Gilberto117mx/Custodia-ISL-PCB-firmware-RAK4630-v1/tests/ISL_Flash_Probe/probe_result.txt

ISL flash probe: walking api.system.flash ...
  ok up to 0x0000 (0 B)
  ok up to 0x1000 (4096 B)
  ok up to 0x2000 (8192 B)
  ok up to 0x3000 (12288 B)
  ok up to 0x4000 (16384 B)
  ok up to 0x5000 (20480 B)
  ok up to 0x6000 (24576 B)
  ok up to 0x7000 (28672 B)
  ok up to 0x8000 (32768 B)
  ok up to 0x9000 (36864 B)
  ok up to 0xA000 (40960 B)
  ok up to 0xB000 (45056 B)
  ok up to 0xC000 (49152 B)
  ok up to 0xD000 (53248 B)
  ok up to 0xE000 (57344 B)
  ok up to 0xF000 (61440 B)
  ok up to 0x10000 (65536 B)
  ok up to 0x11000 (69632 B)
  ok up to 0x12000 (73728 B)
  ok up to 0x13000 (77824 B)
  ok up to 0x14000 (81920 B)
  ok up to 0x15000 (86016 B)
  ok up to 0x16000 (90112 B)
  ok up to 0x17000 (94208 B)
  ok up to 0x18000 (98304 B)
  ok up to 0x19000 (102400 B)
  ok up to 0x1A000 (106496 B)
  ok up to 0x1B000 (110592 B)
  ok up to 0x1C000 (114688 B)
  ok up to 0x1D000 (118784 B)
  ok up to 0x1E000 (122880 B)
  ok up to 0x1F000 (126976 B)
  ok up to 0x20000 (131072 B)
  ceiling at offset 0x21000 (135168 B): set=0 get=0 match=0

=== USABLE api.system.flash ~= 134928 bytes (131 KB) ===
accel records that fit (record = 12 + samples*6 bytes):
  10s @ 10 Hz = 100 samp ->  612 B/rec ->  220 records fit  (~55.0 days @ 6 h cadence)
  10s @  5 Hz =  50 samp ->  312 B/rec ->  432 records fit  (~108.0 days @ 6 h cadence)
   5s @ 10 Hz =  50 samp ->  312 B/rec ->  432 records fit  (~108.0 days @ 6 h cadence)
   5s @  5 Hz =  25 samp ->  162 B/rec ->  832 records fit  (~208.0 days @ 6 h cadence)
   5s @  4 Hz =  20 samp ->  132 B/rec -> 1021 records fit  (~255.2 days @ 6 h cadence)
   3s @  5 Hz =  15 samp ->  102 B/rec -> 1322 records fit  (~330.5 days @ 6 h cadence)

Done. Re-flash production firmware to start with clean flash.
