Gilberto117mx/Custodia-ISL-PCB-firmware-RAK4630-v1/tests/ISL_DeepSleep_Baseline/PowerProfile_baseline.csv

Timestamp(ms) | Current(uA)
0 | 0.149
10 | 0.156
20 | 0.168
30 | 0.171
40 | 0.167
50 | 0.154
60 | 0.151
70 | 0.157
80 | 0.164
90 | 0.157
100 | 0.156
110 | 0.160
120 | 0.164
130 | 0.161
140 | 0.164
150 | 0.172
160 | 0.176
170 | 0.168
180 | 0.166
190 | 0.167
200 | 0.175
210 | 0.179
220 | 0.177
230 | 0.167
240 | 0.156
250 | 0.156
260 | 0.156
270 | 0.153
280 | 0.154
290 | 0.155
300 | 0.151
310 | 0.158
320 | 0.154
330 | 0.157
340 | 0.156
350 | 0.150
360 | 0.145
370 | 0.143
380 | 0.132
390 | 0.141
400 | 0.149
410 | 0.151
420 | 0.144
430 | 0.136
440 | 0.143
450 | 0.140
460 | 0.136
470 | 0.140
480 | 0.134
490 | 0.136
500 | 0.134
510 | 0.138
520 | 0.137
530 | 0.136
540 | 0.140
550 | 0.146
560 | 0.146
570 | 0.147
580 | 0.141
590 | 0.133
600 | 0.136
610 | 0.131
620 | 0.127
630 | 0.133
640 | 0.135
650 | 0.139
660 | 0.136
670 | 0.140
680 | 0.134
690 | 0.132
700 | 0.132
710 | 0.138
720 | 0.137
730 | 0.135
740 | 0.134
750 | 0.134
760 | 0.128
770 | 0.116
780 | 0.119
790 | 0.123
800 | 0.131
810 | 0.132
820 | 0.135
830 | 0.128
840 | 0.116
850 | 0.116
860 | 0.129
870 | 0.136
880 | 0.135
890 | 0.130
900 | 0.134
910 | 0.122
920 | 0.117
930 | 0.116
940 | 0.118
950 | 0.125
960 | 0.133
970 | 0.123
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
