Gilberto117mx/Custodia-ISL-PCB-firmware-RAK4630-v1/tests/ISL_GNSS_DutyCycle/PowerProfile_v2_phantom-power.csv

Timestamp(ms) | Current(uA)
0 | 0.196
10 | 0.193
20 | 0.188
30 | 0.186
40 | 0.186
50 | 0.183
60 | 0.186
70 | 0.186
80 | 0.190
90 | 0.195
100 | 0.196
110 | 0.190
120 | 0.180
130 | 0.177
140 | 0.188
150 | 0.195
160 | 0.196
170 | 0.191
180 | 0.184
190 | 0.182
200 | 0.187
210 | 0.190
220 | 0.188
230 | 0.189
240 | 0.191
250 | 0.177
260 | 0.172
270 | 0.163
280 | 0.165
290 | 0.157
300 | 0.166
310 | 0.160
320 | 0.167
330 | 0.171
340 | 0.172
350 | 0.176
360 | 0.175
370 | 0.167
380 | 0.161
390 | 0.164
400 | 0.164
410 | 0.168
420 | 0.168
430 | 0.167
440 | 0.163
450 | 0.160
460 | 0.158
470 | 0.150
480 | 0.155
490 | 0.158
500 | 0.145
510 | 0.155
520 | 0.155
530 | 0.156
540 | 0.154
550 | 0.157
560 | 0.156
570 | 0.164
580 | 0.172
590 | 0.177
600 | 0.171
610 | 0.172
620 | 0.170
630 | 0.170
640 | 0.160
650 | 0.158
660 | 0.157
670 | 0.159
680 | 0.153
690 | 0.158
700 | 0.156
710 | 0.151
720 | 0.163
730 | 0.155
740 | 0.146
750 | 0.141
760 | 0.146
770 | 0.148
780 | 0.149
790 | 0.153
800 | 0.149
810 | 0.146
820 | 0.144
830 | 0.143
840 | 0.163
850 | 0.156
860 | 0.151
870 | 0.157
880 | 0.153
890 | 0.148
900 | 0.152
910 | 0.147
920 | 0.144
930 | 0.151
940 | 0.153
950 | 0.143
960 | 0.140
970 | 0.142
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
