Gilberto117mx/Custodia-ISL-PCB-firmware-RAK4630-v1/tests/ISL_GNSS_DutyCycle/PowerProfile_v3_isolated.csv

Timestamp(ms) | Current(uA)
0 | 0.138
10 | 0.166
20 | 0.169
30 | 0.170
40 | 0.171
50 | 0.171
60 | 0.171
70 | 0.168
80 | 0.168
90 | 0.174
100 | 0.173
110 | 0.166
120 | 0.162
130 | 0.162
140 | 0.156
150 | 0.167
160 | 0.166
170 | 0.171
180 | 0.167
190 | 0.161
200 | 0.160
210 | 0.167
220 | 0.156
230 | 0.153
240 | 0.154
250 | 0.159
260 | 0.158
270 | 0.151
280 | 0.159
290 | 0.162
300 | 0.158
310 | 0.170
320 | 0.172
330 | 0.160
340 | 0.161
350 | 0.152
360 | 0.147
370 | 0.147
380 | 0.151
390 | 0.154
400 | 0.151
410 | 0.141
420 | 0.151
430 | 0.143
440 | 0.142
450 | 0.153
460 | 0.156
470 | 0.164
480 | 0.168
490 | 0.163
500 | 0.165
510 | 0.165
520 | 0.162
530 | 0.157
540 | 0.155
550 | 0.154
560 | 0.160
570 | 0.151
580 | 0.148
590 | 0.139
600 | 0.135
610 | 0.135
620 | 0.143
630 | 0.138
640 | 0.139
650 | 0.134
660 | 0.129
670 | 0.137
680 | 0.127
690 | 0.130
700 | 0.131
710 | 0.126
720 | 0.125
730 | 0.128
740 | 0.125
750 | 0.117
760 | 0.117
770 | 0.123
780 | 0.129
790 | 0.125
800 | 0.122
810 | 0.130
820 | 0.118
830 | 0.118
840 | 0.118
850 | 0.113
860 | 0.109
870 | 0.120
880 | 0.125
890 | 0.123
900 | 0.128
910 | 0.120
920 | 0.118
930 | 0.121
940 | 0.126
950 | 0.138
960 | 0.137
970 | 0.136
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
