Gilberto117mx/Custodia-ISL-PCB-firmware-RAK4630-v1/production/v6/tests/test2_delivery_guarantee/Tracker_test2.txt

ISL Production v6 boot. Heartbeat, then init...
Current Work Mode: LoRa P2P.
[alive] 0 ms
[alive] 500 ms
[alive] 1000 ms
[alive] 1500 ms
[alive] 2000 ms
[alive] 2500 ms
[alive] 3000 ms
========================================================
ISL Board - PRODUCTION v6  (SV-gated GPS + backoff + fix re-sync + delivery guarantee)
========================================================
[RTC] NOT GPS-synced (will seed from GNSS)  current: 2000-01-01 00:00:05
[FLASH] Loaded: nextSeq=77 delivered=69 undelivered=1 buf=0 pend=5
[TIME] boot GPS time-sync (up to 120 s, no fix needed)...
[GPS] VCC ON (P1.02 LOW, hot start via module backup battery)
   ...0s  sats=0  timeValid=0 year=0
[RTC] SET FROM GPS: 2026-07-15 08:16:10 UTC (unix~1784103370)
[GPS] VCC OFF, UART pins driven LOW (module isolated)
[CFG] id=051  period=2 min (1Hz tick)  SV_MIN=4  no_sky_abort=25 s  fix_max=120 s  settle=5 s  ack=8 s  backoff=K999/360min  tx_gap=30 s  buffer=1  pend_slots=5  WUR_wake=0  SIM_FIX=1  rtcSynced=1
== COLLECT (cycle 1, up 8 s, noFixStreak=0) ==
[BAT] 3905 mV
[GPS] SIMULATED FIX  used=12  IN-VIEW=12  lat=22528600 lon=113940480  ts=1784103370
[BUF] staged seq=77 (fix), buf=1/1  pend=5
[TX pass] cycle=1 buffer=1 pending=5
[TX] seq=77 (fix): 051,77,22.528600,113.940480,3.90,1784103370,SV=12
+EVT:TXP2P DONE
+EVT:RXP2P RECEIVE TIMEOUT
[RX] not-ACK ("")
[TX pass] done: delivered=69 lastSeq=70 pending=5 undelivered=2
== IDLE deep-sleep 120 s ==
[SLEEP] 120 s
[RTC] timer: preset=120 s (1 Hz tick)
[WAKE] RTC P0.21 after ~120002 ms
== COLLECT (cycle 2, up 137 s, noFixStreak=0) ==
[BAT] 3920 mV
[GPS] SIMULATED FIX  used=12  IN-VIEW=12  lat=22528600 lon=113940480  ts=1784103499
[BUF] staged seq=78 (fix), buf=1/1  pend=5
[TX pass] cycle=2 buffer=1 pending=5
[TX] seq=78 (fix): 051,78,22.528600,113.940480,3.92,1784103499,SV=12
+EVT:TXP2P DONE
+EVT:RXP2P RECEIVE TIMEOUT
[RX] not-ACK ("")
[TX pass] done: delivered=69 lastSeq=70 pending=5 undelivered=3
== IDLE deep-sleep 120 s ==
[SLEEP] 120 s
[RTC] timer: preset=120 s (1 Hz tick)
[WAKE] RTC P0.21 after ~120002 ms
== COLLECT (cycle 3, up 266 s, noFixStreak=0) ==
[BAT] 3920 mV
[GPS] SIMULATED FIX  used=12  IN-VIEW=12  lat=22528600 lon=113940480  ts=1784103628
[BUF] staged seq=79 (fix), buf=1/1  pend=5
[TX pass] cycle=3 buffer=1 pending=5
[TX] seq=79 (fix): 051,79,22.528600,113.940480,3.92,1784103628,SV=12
+EVT:TXP2P DONE
+EVT:RXP2P RECEIVE TIMEOUT
[RX] not-ACK ("")
[TX pass] done: delivered=69 lastSeq=70 pending=5 undelivered=4
== IDLE deep-sleep 120 s ==
[SLEEP] 120 s
[RTC] timer: preset=120 s (1 Hz tick)
[WAKE] RTC P0.21 after ~120002 ms
== COLLECT (cycle 4, up 395 s, noFixStreak=0) ==
[BAT] 3920 mV
[GPS] SIMULATED FIX  used=12  IN-VIEW=12  lat=22528600 lon=113940480  ts=1784103757
[BUF] staged seq=80 (fix), buf=1/1  pend=5
[TX pass] cycle=4 buffer=1 pending=5
[TX] seq=80 (fix): 051,80,22.528600,113.940480,3.92,1784103757,SV=12
+EVT:TXP2P DONE
+EVT:RXP2P RECEIVE TIMEOUT
[RX] not-ACK ("")
[TX pass] done: delivered=69 lastSeq=70 pending=5 undelivered=5
== IDLE deep-sleep 120 s ==
[SLEEP] 120 s
[RTC] timer: preset=120 s (1 Hz tick)
[WAKE] RTC P0.21 after ~120002 ms
== COLLECT (cycle 5, up 524 s, noFixStreak=0) ==
[BAT] 3920 mV
[GPS] SIMULATED FIX  used=12  IN-VIEW=12  lat=22528600 lon=113940480  ts=1784103886
[BUF] staged seq=81 (fix), buf=1/1  pend=5
[TX pass] cycle=5 buffer=1 pending=5
[TX] seq=81 (fix): 051,81,22.528600,113.940480,3.92,1784103886,SV=12
+EVT:TXP2P DONE
+EVT:RXP2P RECEIVE TIMEOUT
[RX] not-ACK ("")
[TX pass] done: delivered=69 lastSeq=70 pending=5 undelivered=6
== IDLE deep-sleep 120 s ==
[SLEEP] 120 s
[RTC] timer: preset=120 s (1 Hz tick)
[WAKE] RTC P0.21 after ~120002 ms
== COLLECT (cycle 6, up 653 s, noFixStreak=0) ==
[BAT] 3918 mV
[GPS] SIMULATED FIX  used=12  IN-VIEW=12  lat=22528600 lon=113940480  ts=1784104015
[BUF] staged seq=82 (fix), buf=1/1  pend=5
[TX pass] cycle=6 buffer=1 pending=5
[TX] seq=82 (fix): 051,82,22.528600,113.940480,3.91,1784104015,SV=12
+EVT:TXP2P DONE
+EVT:RXP2P RECEIVE TIMEOUT
[RX] not-ACK ("")
[TX pass] done: delivered=69 lastSeq=70 pending=5 undelivered=7
== IDLE deep-sleep 120 s ==
[SLEEP] 120 s
[RTC] timer: preset=120 s (1 Hz tick)
[WAKE] RTC P0.21 after ~120002 ms
== COLLECT (cycle 7, up 782 s, noFixStreak=0) ==
[BAT] 3922 mV
[GPS] SIMULATED FIX  used=12  IN-VIEW=12  lat=22528600 lon=113940480  ts=1784104144
[BUF] staged seq=83 (fix), buf=1/1  pend=5
[TX pass] cycle=7 buffer=1 pending=5
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
[GPS] SIMULATED FIX  used=12  IN-VIEW=12  lat=22528600 lon=113940480  ts=1784105032
[BUF] staged seq=89 (fix), buf=1/1  pend=0
[TX pass] cycle=13 buffer=1 pending=0
[TX] seq=89 (fix): 051,89,22.528600,113.940480,3.92,1784105032,SV=12
+EVT:TXP2P DONE
+EVT:RXP2P:-43:12:41434B2C3035312C3839
[RX] ACK OK  RSSI=-43 dBm  SNR=12 dB
[TX pass] done: delivered=79 lastSeq=89 pending=0 undelivered=9
== IDLE deep-sleep 120 s ==
[SLEEP] 120 s
[RTC] timer: preset=120 s (1 Hz tick)
[WAKE] RTC P0.21 after ~120002 ms
== COLLECT (cycle 14, up 1791 s, noFixStreak=0) ==
[BAT] 3922 mV
[GPS] SIMULATED FIX  used=12  IN-VIEW=12  lat=22528600 lon=113940480  ts=1784105153
[BUF] staged seq=90 (fix), buf=1/1  pend=0
[TX pass] cycle=14 buffer=1 pending=0
[TX] seq=90 (fix): 051,90,22.528600,113.940480,3.92,1784105153,SV=12
+EVT:TXP2P DONE
