Gilberto117mx/Custodia-ISL-PCB-firmware-RAK4630-v1/production/v9/tests/run1_offload_freeze/PowerProfile_USB.csv

Timestamp(ms) | Current(uA)
0 | 43973.828
10 | 44186.281
20 | 43983.094
30 | 43707.031
40 | 43708.441
50 | 44051.719
60 | 44161.512
70 | 43609.816
80 | 43437.457
90 | 43694.848
100 | 43667.754
110 | 43526.535
120 | 43530.848
130 | 43853.684
140 | 43857.953
150 | 43869.301
160 | 43954.832
170 | 44235.293
180 | 44077.715
190 | 43983.281
200 | 43718.848
210 | 43674.629
220 | 43831.023
230 | 43610.117
240 | 43811.750
250 | 43577.898
260 | 43827.250
270 | 43979.270
280 | 43810.207
290 | 43941.363
300 | 43416.352
310 | 43687.121
320 | 43696.695
330 | 43927.598
340 | 44216.496
350 | 44168.738
360 | 44348.844
370 | 44154.051
380 | 44418.051
390 | 44116.723
400 | 44284.387
410 | 44373.641
420 | 44055.703
430 | 44255.930
440 | 44131.910
450 | 44346.637
460 | 43842.785
470 | 43601.746
480 | 43200.898
490 | 43073.918
500 | 43256.453
510 | 43314.125
520 | 43406.965
530 | 43572.652
540 | 43636.496
550 | 43678.758
560 | 43541.586
570 | 43460.000
580 | 43463.301
590 | 43805.402
600 | 43221.473
610 | 43022.820
620 | 43066.617
630 | 43115.617
640 | 42870.645
650 | 42746.645
660 | 43456.723
670 | 43495.516
680 | 43506.172
690 | 43510.637
700 | 43618.375
710 | 43789.953
720 | 43552.316
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
