Gilberto117mx/Custodia-ISL-PCB-firmware-RAK4630-v1/production/v6/tests/test2_delivery_guarantee/PowerProfile_test2.csv

Timestamp(ms) | Current(uA)
0 | 1776.286
10 | 653.905
20 | 240.790
30 | 88.734
40 | 32.764
50 | 12.159
60 | 4.577
70 | 1.788
80 | 0.757
90 | 0.381
100 | 0.239
110 | 0.188
120 | 0.173
130 | 0.174
140 | 0.176
150 | 0.176
160 | 0.171
170 | 0.173
180 | 0.177
190 | 0.169
200 | 0.178
210 | 0.171
220 | 0.178
230 | 0.170
240 | 0.173
250 | 0.177
260 | 0.181
270 | 0.176
280 | 0.178
290 | 0.179
300 | 0.177
310 | 0.174
320 | 0.179
330 | 0.183
340 | 0.181
350 | 0.172
360 | 0.172
370 | 0.174
380 | 0.174
390 | 0.176
400 | 0.183
410 | 0.180
420 | 0.180
430 | 0.182
440 | 0.183
450 | 0.172
460 | 0.172
470 | 0.178
480 | 0.177
490 | 0.175
500 | 0.175
510 | 0.180
520 | 0.172
530 | 0.167
540 | 0.168
550 | 0.166
560 | 0.165
570 | 0.158
580 | 0.159
590 | 0.156
600 | 0.159
610 | 0.162
620 | 0.166
630 | 0.163
640 | 0.157
650 | 0.156
660 | 0.161
670 | 0.167
680 | 0.160
690 | 0.164
700 | 0.158
710 | 0.156
720 | 0.160
730 | 0.159
740 | 0.166
750 | 0.171
760 | 0.160
770 | 0.161
780 | 0.153
790 | 0.152
800 | 0.160
810 | 0.170
820 | 0.167
830 | 0.171
840 | 0.169
850 | 0.158
860 | 0.168
870 | 0.161
880 | 0.158
890 | 0.157
900 | 0.173
910 | 0.177
920 | 0.179
930 | 0.172
940 | 0.167
950 | 0.162
960 | 0.168
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
