Gilberto117mx/Custodia-ISL-PCB-firmware-RAK4630-v1/production/v6/tests/test3_longwake_2h/PowerProfile_test3.csv

Timestamp(ms) | Current(uA)
0 | 0.174
100 | 0.168
200 | 0.171
300 | 0.174
400 | 0.180
500 | 0.172
600 | 0.169
700 | 0.170
800 | 0.165
900 | 0.152
1000 | 0.143
1100 | 0.141
1200 | 0.141
1300 | 0.128
1400 | 0.124
1500 | 0.124
1600 | 0.124
1700 | 0.120
1800 | 0.116
1900 | 0.110
2000 | 0.114
2100 | 0.117
2200 | 0.119
2300 | 0.115
2400 | 0.116
2500 | 0.127
2600 | 0.132
2700 | 0.132
2800 | 0.135
2900 | 0.132
3000 | 0.145
3100 | 0.153
3200 | 0.145
3300 | 0.141
3400 | 0.137
3500 | 6830.948
3600 | 8256.943
3700 | 8970.549
3800 | 9440.239
3900 | 9933.642
4000 | 7406.701
4100 | 6522.923
4200 | 6337.229
4300 | 6283.477
4400 | 6283.930
4500 | 5625.116
4600 | 5836.237
4700 | 5184.413
4800 | 4801.847
4900 | 4577.307
5000 | 4466.833
5100 | 4398.633
5200 | 4352.767
5300 | 4320.183
5400 | 4295.695
5500 | 4276.614
5600 | 4261.320
5700 | 4249.637
5800 | 4244.167
5900 | 4238.976
6000 | 4238.445
6100 | 4236.343
6200 | 4235.019
6300 | 4234.773
6400 | 4234.715
6500 | 4234.744
6600 | 4234.458
6700 | 4232.889
6800 | 4233.399
6900 | 4231.964
7000 | 4233.785
7100 | 4234.469
7200 | 4235.229
7300 | 4235.546
7400 | 4237.019
7500 | 4238.398
7600 | 4238.745
7700 | 4234.144
7800 | 4234.289
7900 | 4234.105
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
