Gilberto117mx/Custodia-ISL-PCB-firmware-RAK4630-v1/hardware/iteration3/RAK_feather_schematic_v3.pdf

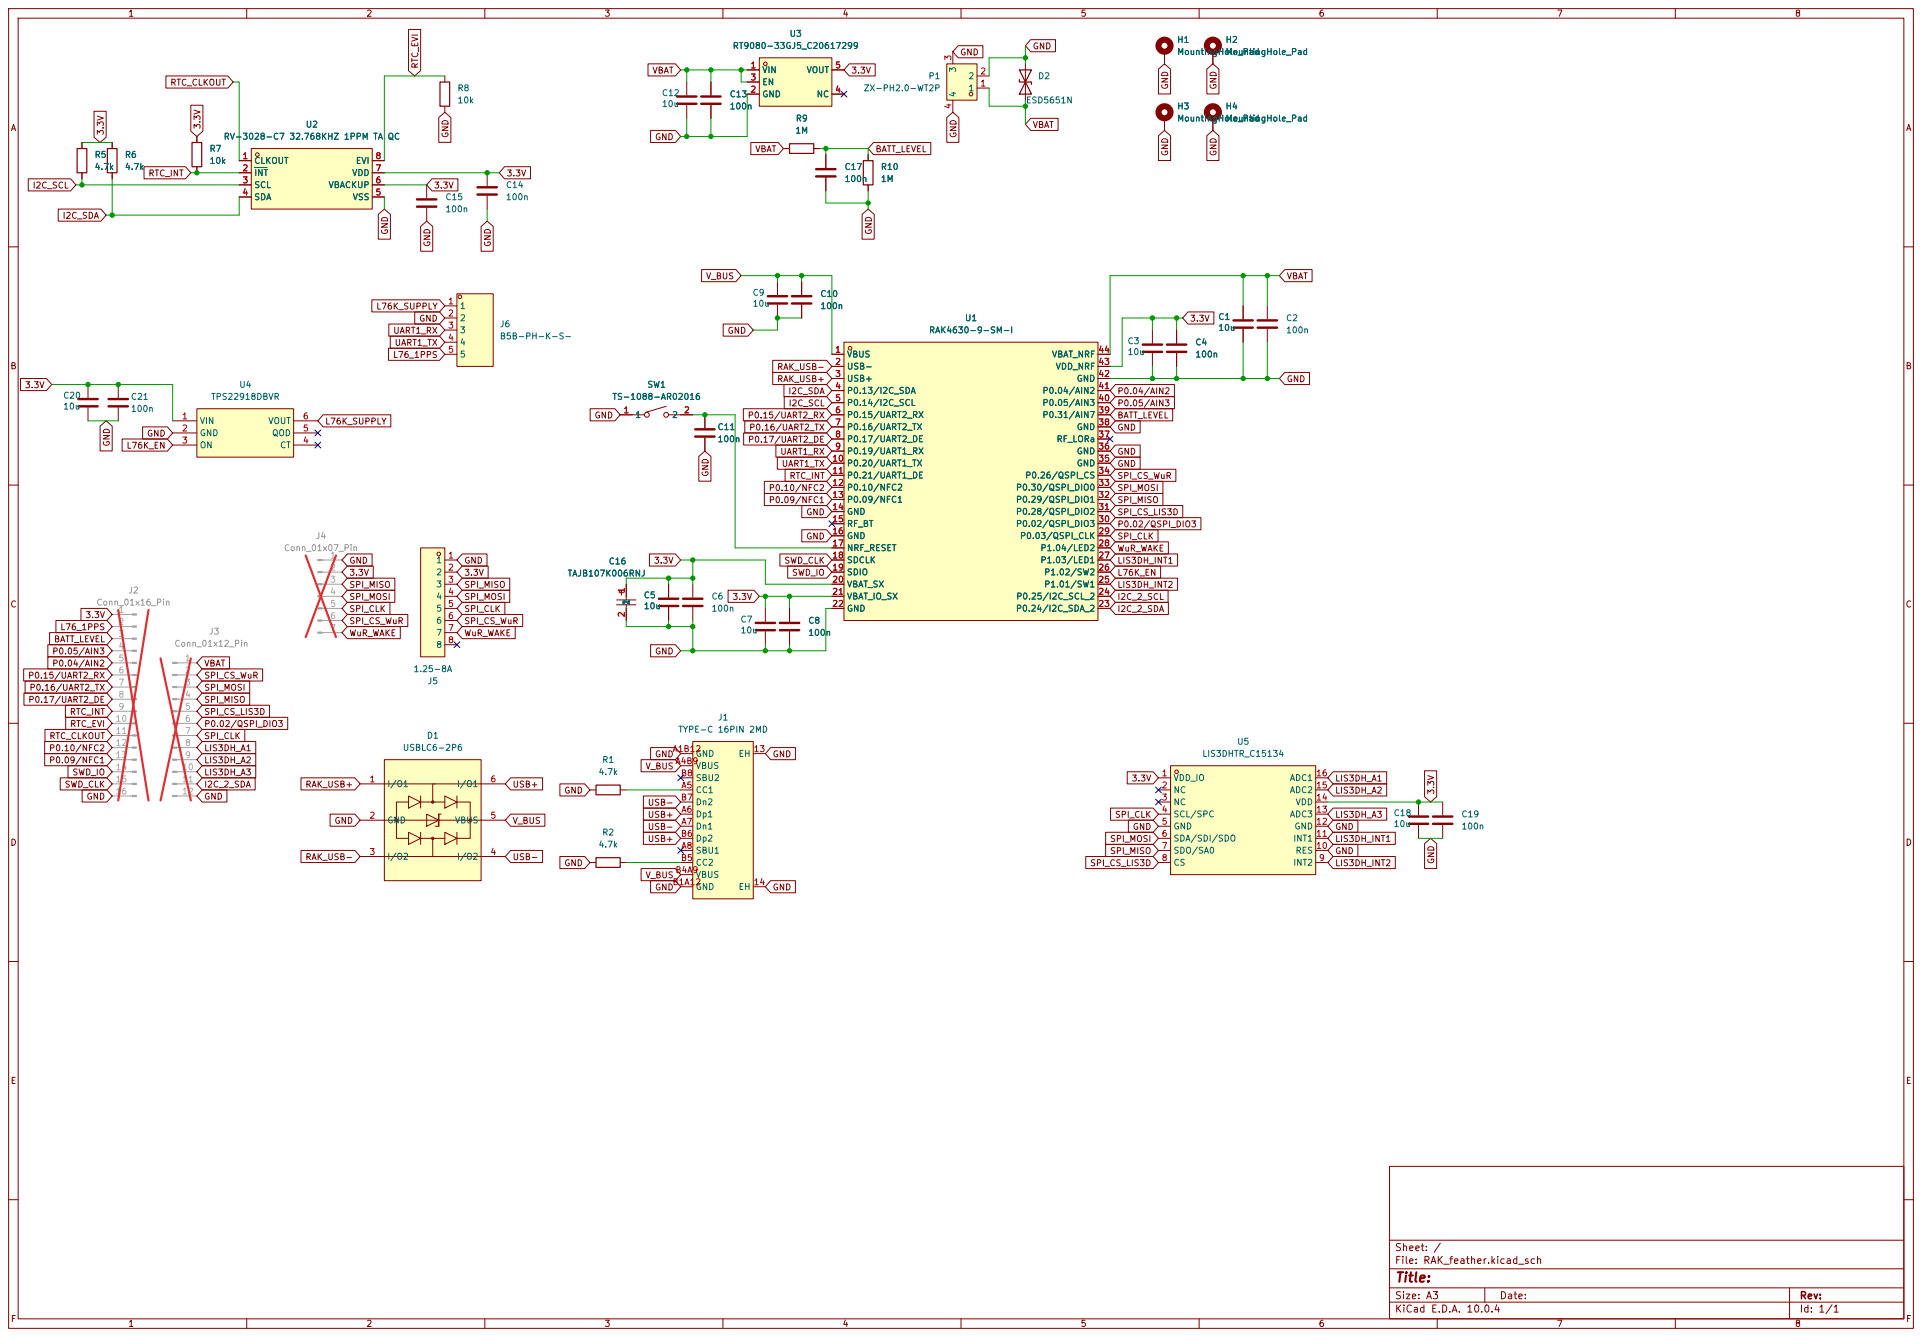
[picture p11: page 1]

VBAT GND GND GND

Size: A3 | Rev: | F Date:
KiCad E.D.A. 10.0.4 | Id: 1/1
