Gilberto117mx/Custodia-ISL-PCB-firmware-RAK4630-v1/hardware/iteration2/RAK_feather_schematic_v2.pdf

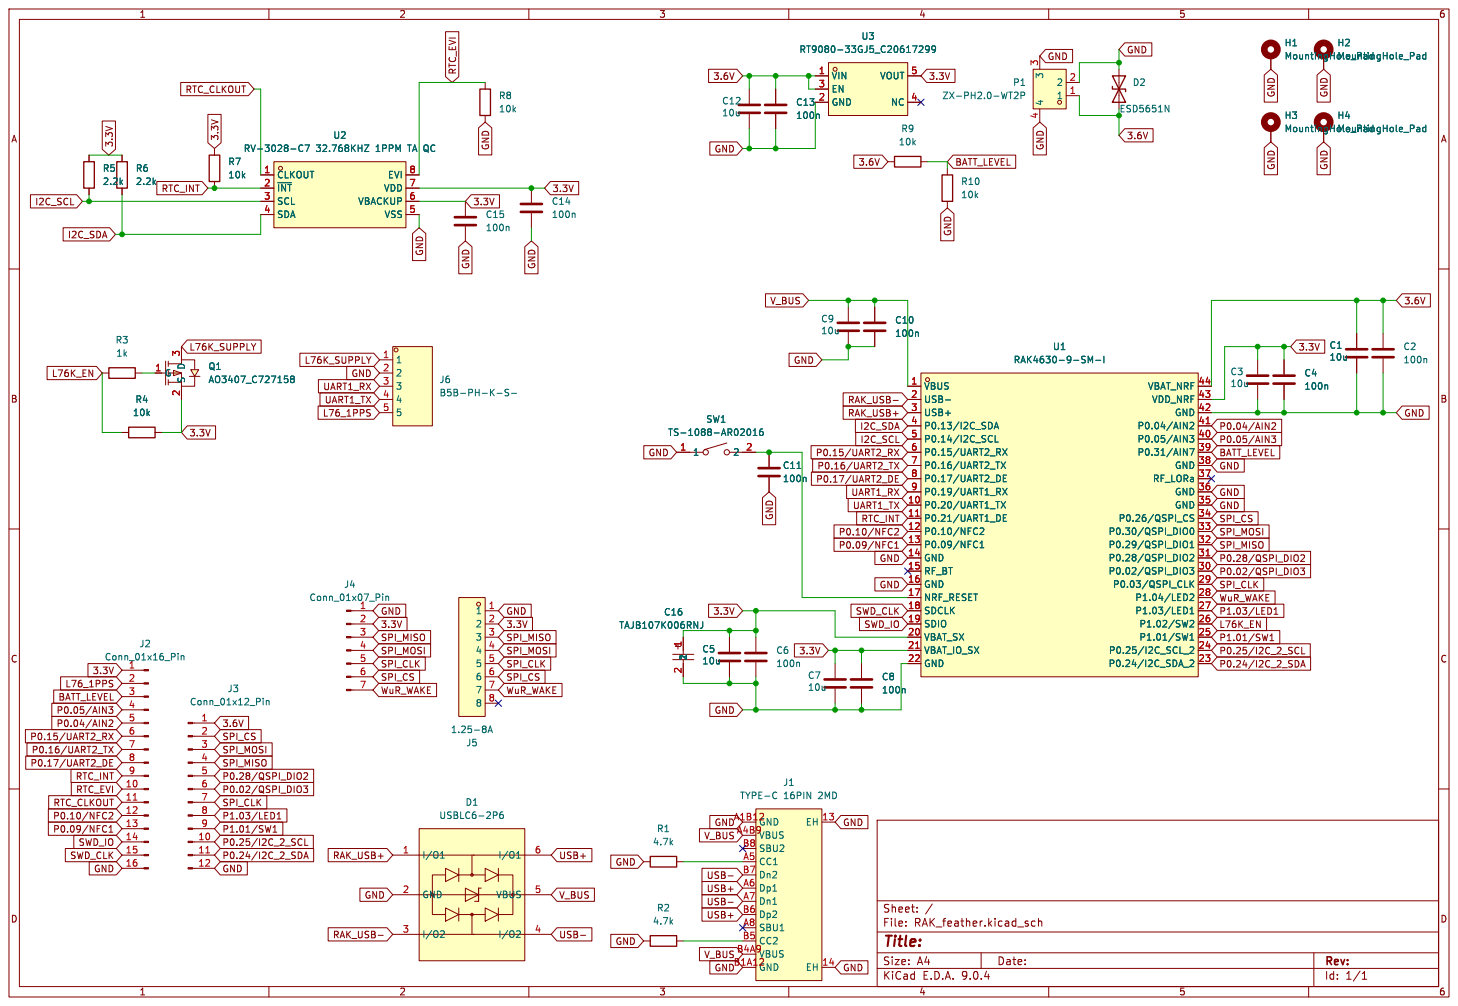
[picture p12: page 1]

J1 TYPE-C 16PIN 2MD
V_BUS USB+ USB+ V_BUS USB- GND

Id: 1/1 Title: File: RAK_feather.kicad_sch Sheet: /
