Gilberto117mx/Custodia-ISL-PCB-firmware-RAK4630-v1/hardware/iteration1/RAK_feather_schematic.pdf

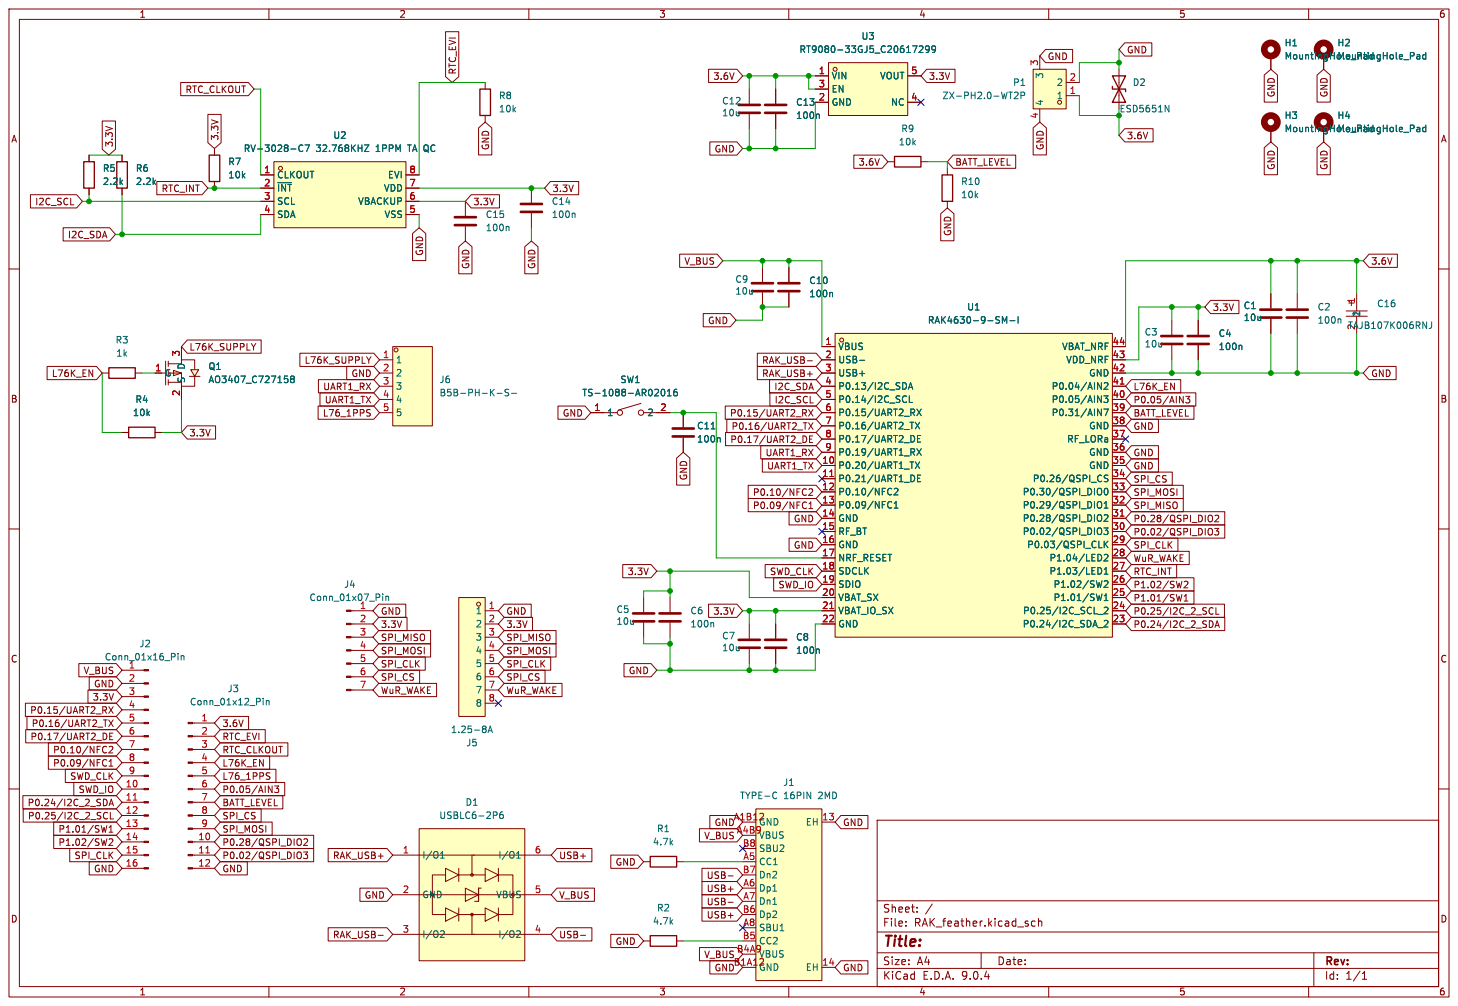
[picture p13: page 1]

Id: 1/1 Title: File: RAK_feather.kicad_sch Sheet: /
