Gilberto117mx/Custodia-ISL-PCB-firmware-RAK4630-v1/(commit log)

2026-07-10 Restructure as standalone ISL Board repository
    Extract the ISL_Board tree from the Custom-PCB-RAK4630-RUI-based monorepo
    into this standalone repository. The ISL_Board contents now live at the repo
    root:
    - docs/ISL_Pinout.md authoritative pin map + hardware notes
    - hardware/iteration1/ RAK_feather schematic, PCB PDF, BOM
    - reference/AS3933_wakeup/ vendor AS3933 wake-up receiver reference
    - tests/ bring-up sketches (I2C scan, RTC, battery, GNSS, WUR)
    Replaces the previous loosely-organized loose files (AS3933_wakeup-main/,
    RAK PCB.pdf, RAK_feather.csv, RAK_feather_schematic.pdf) with the cleaner
    ISL_Board layout, and updates the README to read as a standal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
    [RAK_feather.csv]
2026-07-16 Rebuild as standalone, sanitized ISL Board repository
    Re-clone the full ISL_Board tree (docs, hardware, reference, production
    v1-v6, and bring-up tests) and document it as a self-contained repository
    exclusive to the ISL board.
    All references to the original RAK4630 custom PCB have been removed so
    collaborators get complete ISL context without any details of the other
    board:
    - Dropped the "vs Tracker 6.0" comparison tables and every mention of the
    original board's pins, power tree, and deep-sleep currents.
    - Removed cross-references to the parent monorepo (root pin guide, the
    other board's tests/production, the external receiver path).
    - Rewrote doc/README/.ino comments to stand on thei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
    [PowerProfile_baseline.csv, PowerProfile_run2_15min.csv, PowerProfile_test2.csv, PowerProfile_test3.csv, PowerProfile_v2_phantom-power.csv, PowerProfile_v3_isolated.csv, calibration_data.csv]
2026-08-03 Sync to v17 (final): iteration3 board, WUR+BLE handoff to ISL lab engineers
    Re-sync the standalone ISL Board repository to the latest upstream progress
    (production v1-v17, hardware iteration3, and the new BLE/accelerometer/flash
    bring-up tests) and document the current status.
    Status documented:
    - production/v17 marked as the latest and final firmware version (v16 feature
    set ported to PCB iteration3: onboard LIS3DHTR over SPI + GPS on an
    active-HIGH TPS22918).
    - Deep-sleep floor solved in v7 (AIN7 input-buffer crowbar -> 34 uA); GNSS
    strategy, LoRa delivery-guarantee + 1-week backlog, GPS-disciplined RTC,
    calibrated battery, and accelerometer capture all validated.
    - Added an expli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
    [PowerProfile_USB.csv, PowerProfile_v7_battery.csv, ppk_v10_run1.csv, ppk_v11_run1.csv]
2026-08-03 v17 definitive: iteration3 validation, power profile, and run logs
    Document production v17 as the definitive, validated firmware version.
    - Sync the updated v17 README plus the iteration3 validation evidence:
    VALIDATION.md, the collar/repeater/drone run logs, and the PPK power
    summary (production/v17/logs/).
    - v17 validated on the iteration3 board (2026-08-03): hot GPS fixes
    (TTFF 6-7 s, 21-22 sats), accelerometer over SPI (bad=0), and the LoRa
    delivery-guarantee + 1-week backlog drained 10/10 with zero loss;
    RTC/deep-sleep/battery/flash all good.
    - Document the measured power/lifespan: ~190 uA floor -> ~3.3 yr as-is on a
    9600 mAh cell, and the two optimization-only items (a fix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
2026-08-03 v17: add power-profiling section (per-phase table + current-vs-time graph)
    Add production/v17/POWER_PROFILE.md documenting the iteration3 PPK capture:
    - a per-phase power table (sleep floor, wake, GPS hot fix, LoRa TX, ACK,
    accel, BLE offload) with current, duration, and energy per occurrence;
    - a to-scale current-vs-time SVG graph over one GNSS wake cycle
    (power_profile_v17.svg), plus mermaid bar/pie fallbacks;
    - the bench duty split and the lifespan model.
    Clearly flagged as for power-profiling / information purposes only: the
    capture used an accelerated bench cadence, while real deployment runs with
    much longer, different periods (GNSS ~1 h, accel ~3 h, BLE ~2 wk). Linked
    from the v1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
2026-08-14 Pilot handover: full end-to-end system + WUR/BLE integration caveats
    Turn this into the handover artifact for the first medium-scale pilot,
    combining the latest ISL_Board content with the companion system.
    New / synced:
    - Root HANDOVER.md: end-to-end delivery snapshot (collar + repeater +
    gateway + cloud uploader), pilot-readiness table, power/lifespan, and the
    optimization-only items.
    - SolarNodeSystem/v1: LoRa repeater + gateway + XIAO ESP32-S3 cloud uploader
    + cloud API doc + bench validation (SenseCAP Solar Node P1-Pro / XIAO
    ESP32-S3).
    - v17 real-world validation: REALWORLD_BACKLOG.md + gateway/drone logs (real
    2-day out-of-range trip, 83-packet backlog drained newest-first,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
